gregoryg03/swim_clock_general/README.md

# swim_clock_general
General Project code development and other related files

Basic testing is being conducted on Arduino Uno with 4 7-segment LEDs

Plan to move to ESP 32
