gregoryg03/swim_clock_general/hardware/bps_board_v2/bps_board_v2.kicad_pcb

## KiCad design hardware/bps_board_v2/bps_board_v2.kicad_pcb (2026-05-01)

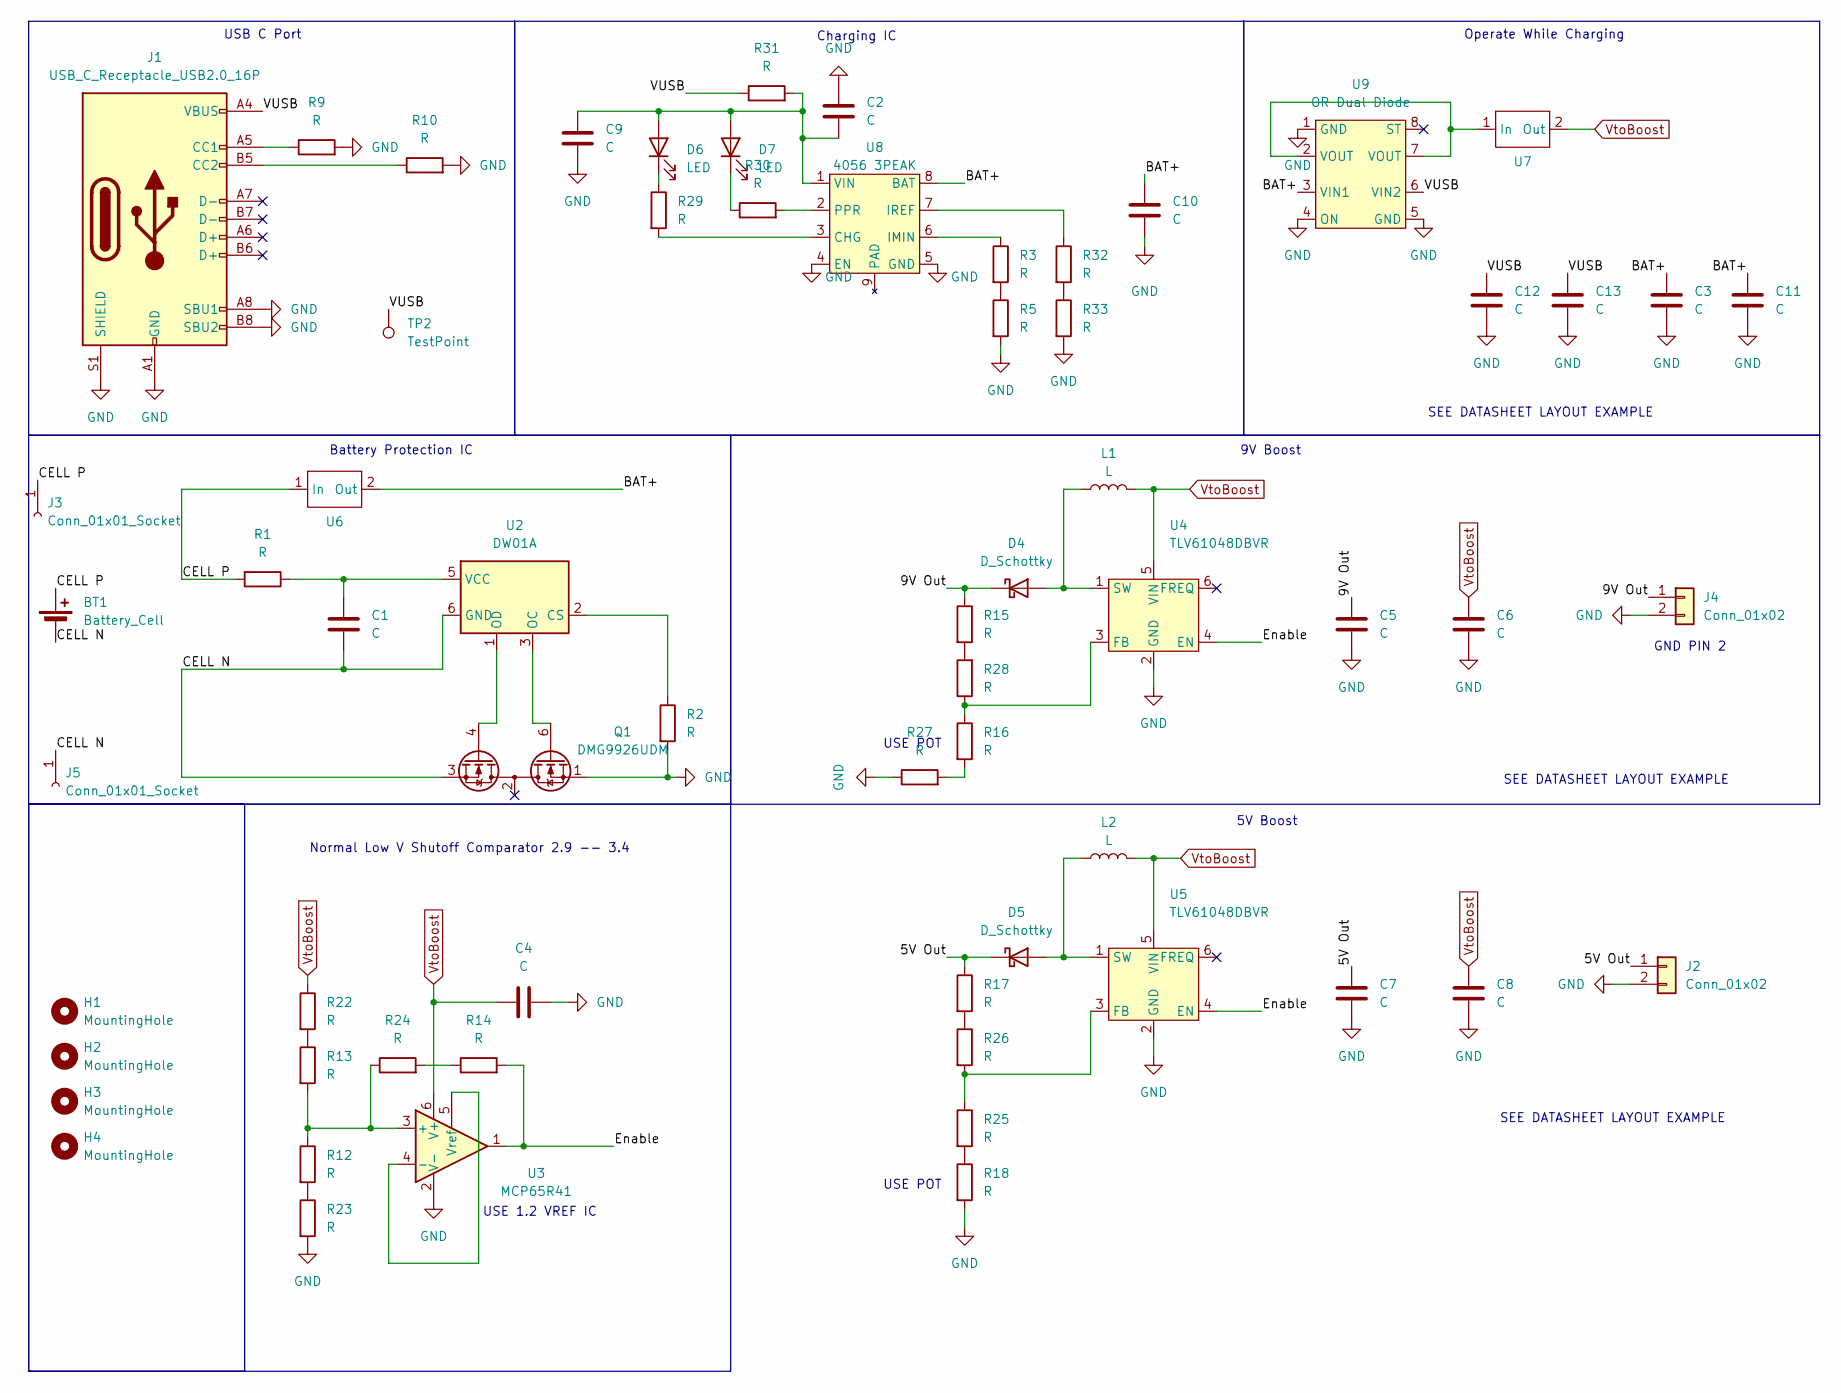
[picture p1: schematic bps_board_v2.kicad_sch, BPS Circuit Board]

Parts:
BT1: Battery_Cell; 18650 8mm Strip
C1, C2, C3, C4, C5, C6, C7, C8, C9, C10, C11, C12, C13: C; C_1206_3216Metric_Pad1.33x1.80mm_HandSolder
D4, D5: D_Schottky; MBRS130LT3G Diode
D6, D7: LED; LED_0603_1608Metric_Pad1.05x0.95mm_HandSolder
H1, H2, H3, H4: MountingHole; MountingHole_3.2mm_M3
J1: USB_C_Receptacle_USB2.0_16P; USB_C_Receptacle_GCT_USB4085
J2, J4: Conn_01x02; JST_EH_B2B-EH-A_1x02_P2.50mm_Vertical
J3, J5: Conn_01x01_Socket; EmptyPad
L1, L2: L; InductorFixed
Q1: DMG9926UDM; SOT-23-6
R1, R2, R3, R5, R9, R10, R12, R13, R14, R15, R16, R17, R18, R22, R23, R24, R25, R26, R27, R28, R29, R30, R31, R32, R33: R; R_1206_3216Metric_Pad1.30x1.75mm_HandSolder
TP2: TestPoint; TestPoint_THTPad_2.5x2.5mm_Drill1.2mm
U2: DW01A; SOT-23-6
U3: MCP65R41; SOT-23-6
U4, U5: TLV61048DBVR; SOT-23-6_Handsoldering
U6, U7: 22AWG Wire Jump
U8: 4056 3PEAK; SOIC-8-1EP_3.9x4.9mm_P1.27mm_EP2.41x3.3mm_ThermalVias
U9: OR Dual Diode; SOT-583-8

Connections:
/5V Out: C7.1, D5.1 (K), J2.1, R17.1
/9V Out: C5.1, D4.1 (K), J4.1, R15.1
/BAT+: C3.1, C10.1, C11.1, U6.2 (Out), U8.8 (BAT), U9.3 (VIN1)
/CELL N: BT1.2 (-), C1.2, J5.1, Q1.3 (S2), U2.6 (GND)
/CELL P: BT1.1 (+), J3.1, R1.2, U6.1 (In)
/Enable: R14.2, U3.1, U4.4 (EN), U5.4 (EN)
/VUSB: C12.1, C13.1, J1.A4 (VBUS), J1.A9 (VBUS), J1.B4 (VBUS), J1.B9 (VBUS), R31.1, TP2.1, U9.6 (VIN2)
GND: C2.1, C3.2, C4.2, C5.2, C6.2, C7.2, C8.2, C9.2, C10.2, C11.2, C12.2, C13.2, J1.A1 (GND), J1.A8 (SBU1), J1.A12 (GND), J1.B1 (GND), J1.B8 (SBU2), J1.B12 (GND), J1.S1 (SHIELD), J2.2, J4.2, Q1.1 (D1), R2.2, R5.2, R9.2, R10.2, R18.2, R23.2, R27.1, R33.2, U3.2 (V-), U4.2 (GND), U5.2 (GND), U8.4 (EN), U8.5 (GND), U9.1 (GND), U9.4 (ON), U9.5 (GND)
unnamed: D4.2 (A), L1.1, U4.1 (SW)
unnamed: D5.2 (A), L2.1, U5.1 (SW)
unnamed: C2.2, C9.1, D6.2 (A), D7.2 (A), R31.2, U8.1 (VIN)
unnamed: D6.1 (K), R29.1
unnamed: D7.1 (K), R30.1
unnamed: J1.A5 (CC1), R9.1
unnamed: J1.B5 (CC2), R10.1
unnamed: Q1.6 (G1), U2.3 (OC)
unnamed: Q1.4 (G2), U2.1 (OD)
unnamed: R3.2, R5.1
unnamed: R12.2, R23.1
unnamed: R13.1, R22.2
unnamed: R14.1, R24.2
unnamed: R15.2, R28.2
unnamed: R16.2, R27.2
unnamed: R17.2, R26.1
unnamed: R18.1, R25.2
unnamed: R32.2, R33.1
unnamed: R2.1, U2.2 (CS)
unnamed: C1.1, R1.1, U2.5 (VCC)
unnamed: R12.1, R13.2, R24.1, U3.3 (+)
unnamed: U3.4 (-), U3.5 (Vref)
unnamed: R16.1, R28.1, U4.3 (FB)
unnamed: R25.1, R26.2, U5.3 (FB)
unnamed: U7.1 (In), U9.2 (VOUT), U9.7 (VOUT)
unnamed: R29.2, U8.3 (CHG)
unnamed: R3.1, U8.6 (IMIN)
unnamed: R32.1, U8.7 (IREF)
unnamed: R30.2, U8.2 (PPR)
VtoBoost: C4.1, C6.1, C8.1, L1.2, L2.2, R22.1, U3.6 (V+), U4.5 (VIN), U5.5 (VIN), U7.2 (Out)

Notes on the sheet:
USE 1.2 VREF IC
SEE DATASHEET LAYOUT EXAMPLE
Battery Protection IC
Charging IC
GND PIN 2
USE POT
5V Boost
Operate While Charging
USB C Port
Normal Low V Shutoff Comparator 2.9 -- 3.4
9V Boost

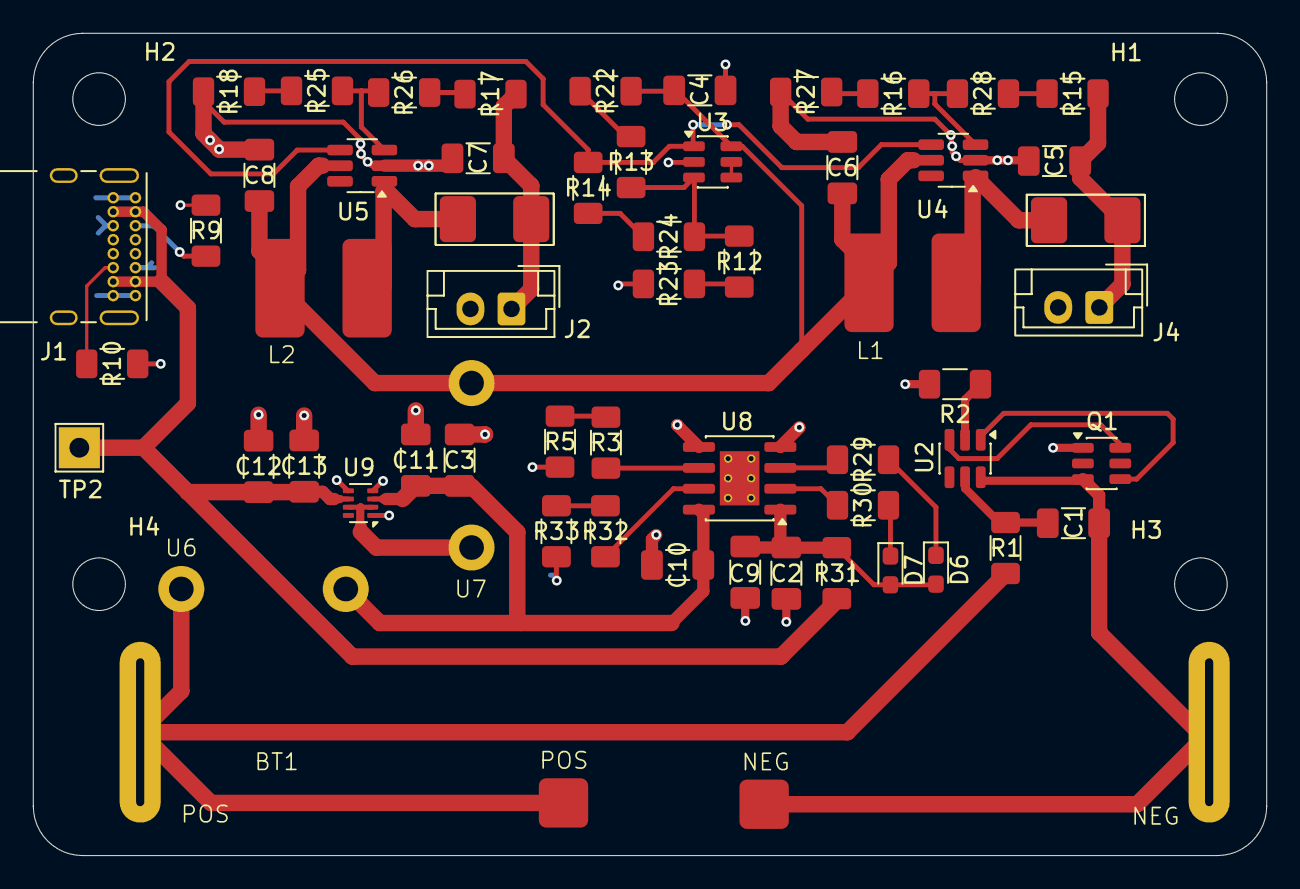
[picture p2: board bps_board_v2.kicad_pcb from above]

Board: 2 copper layers, 75.0 x 50.0 mm, 64 parts (0 on the bottom side), 38 nets.
