gregoryg03/swim_clock_general/hardware/main_board_v2/MainBoard4Layer/MainBoard4Layer.kicad_pcb

## KiCad design hardware/main_board_v2/MainBoard4Layer/MainBoard4Layer.kicad_pcb (2026-04-23)

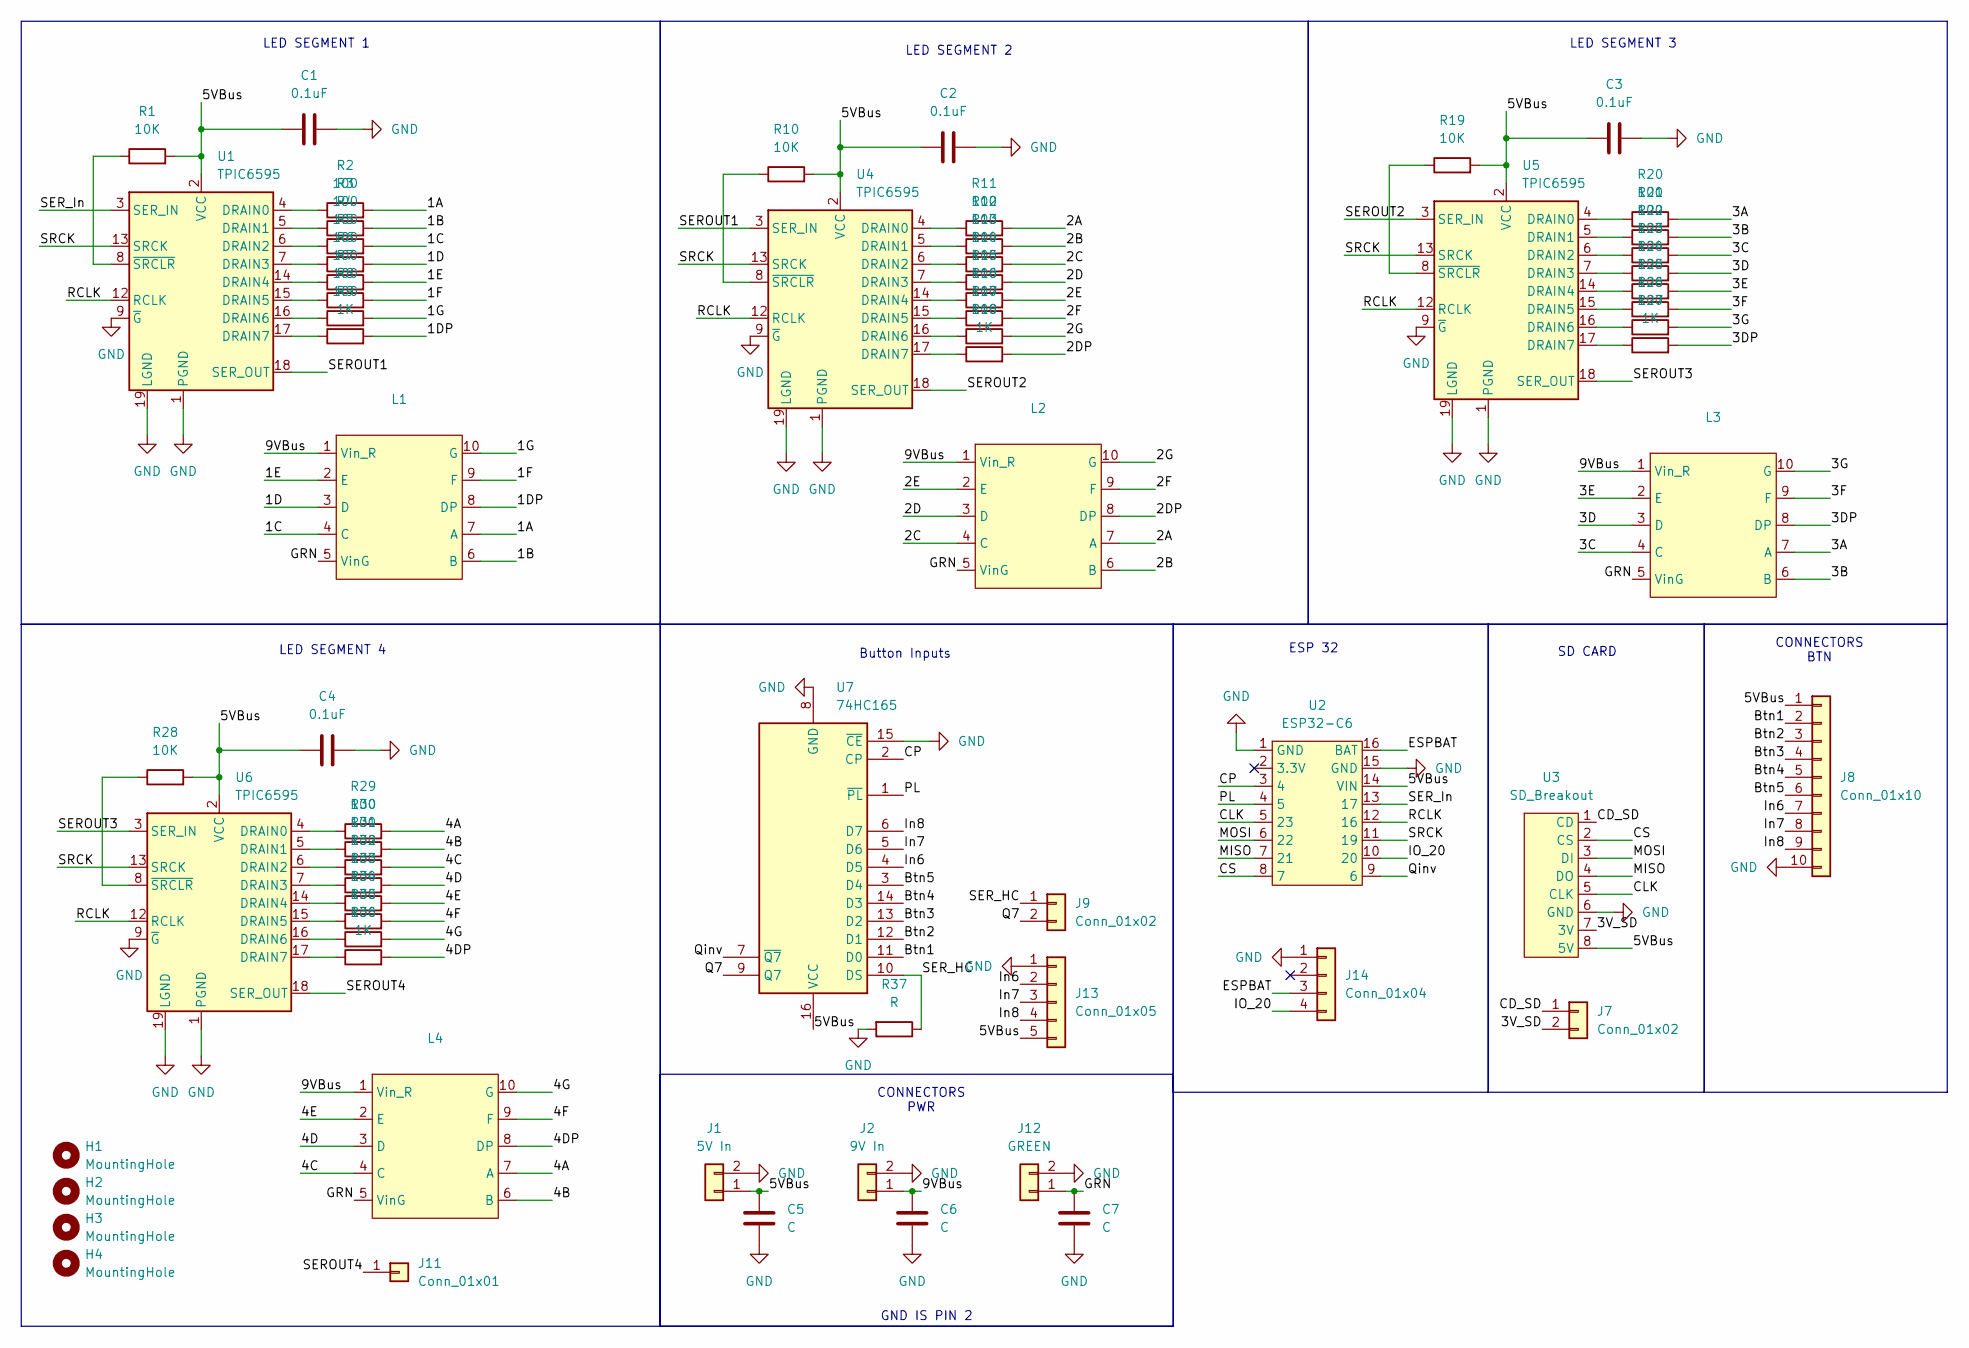
[picture p3: schematic MainBoard4Layer.kicad_sch]

Parts:
C1, C2, C3, C4: 0.1uF; C_1206_3216Metric_Pad1.33x1.80mm_HandSolder
C5, C6, C7: C; C_1206_3216Metric_Pad1.33x1.80mm_HandSolder
H1, H2, H3, H4: MountingHole; MountingHole_3.2mm_M3
J1: 5V In; JST_EH_B2B-EH-A_1x02_P2.50mm_Vertical
J2: 9V In; JST_EH_B2B-EH-A_1x02_P2.50mm_Vertical
J7, J9: Conn_01x02; PinHeader_1x02_P2.54mm_Vertical
J8: Conn_01x10; MOLEX_10_PIN
J11: Conn_01x01; PinSocket_1x01_P2.54mm_Vertical
J12: GREEN; JST_EH_B2B-EH-A_1x02_P2.50mm_Vertical
J13: Conn_01x05; PinHeader_1x05_P2.54mm_Vertical
J14: Conn_01x04; PinHeader_1x04_P2.54mm_Vertical
L1, L2, L3, L4: 7SEG_LED_2.3IN
R1, R10, R19, R28: 10K; R_1206_3216Metric_Pad1.30x1.75mm_HandSolder
R2, R3, R4, R5, R6, R7, R8, R11, R12, R13, R14, R15, R16, R17, R20, R21, R22, R23, R24, R25, R26, R29, R30, R31, R32, R33, R34, R35: 100; R_1206_3216Metric_Pad1.30x1.75mm_HandSolder
R9, R18, R27, R36: 1K; R_1206_3216Metric_Pad1.30x1.75mm_HandSolder
R37: R; R_1206_3216Metric_Pad1.30x1.75mm_HandSolder
U1, U4, U5, U6: TPIC6595; DIP-20_W7.62mm_Socket
U2: ESP32-C6; ESPC6_BEETLE
U3: SD_Breakout; SD Card
U7: 74HC165; DIP-16_W7.62mm_Socket

Connections:
/1A: L1.7 (A), R2.2
/1B: L1.6 (B), R3.2
/1C: L1.4 (C), R4.2
/1D: L1.3 (D), R5.2
/1DP: L1.8 (DP), R9.2
/1E: L1.2 (E), R6.2
/1F: L1.9 (F), R7.2
/1G: L1.10 (G), R8.2
/2A: L2.7 (A), R11.2
/2B: L2.6 (B), R12.2
/2C: L2.4 (C), R13.2
/2D: L2.3 (D), R14.2
/2DP: L2.8 (DP), R18.2
/2E: L2.2 (E), R15.2
/2F: L2.9 (F), R16.2
/2G: L2.10 (G), R17.2
/3A: L3.7 (A), R20.2
/3B: L3.6 (B), R21.2
/3C: L3.4 (C), R22.2
/3D: L3.3 (D), R23.2
/3DP: L3.8 (DP), R27.2
/3E: L3.2 (E), R24.2
/3F: L3.9 (F), R25.2
/3G: L3.10 (G), R26.2
/3V_SD: J7.2, U3.7 (3V)
/4A: L4.7 (A), R29.2
/4B: L4.6 (B), R30.2
/4C: L4.4 (C), R31.2
/4D: L4.3 (D), R32.2
/4DP: L4.8 (DP), R36.2
/4E: L4.2 (E), R33.2
/4F: L4.9 (F), R34.2
/4G: L4.10 (G), R35.2
/5VBus: C1.1, C2.1, C3.1, C4.1, C5.1, J1.1, J8.1, J13.5, R1.2, R10.2, R19.2, R28.2, U1.2 (VCC), U2.14 (VIN), U3.8 (5V), U4.2 (VCC), U5.2 (VCC), U6.2 (VCC), U7.16 (VCC)
/9VBus: C6.1, J2.1, L1.1 (Vin_R), L2.1 (Vin_R), L3.1 (Vin_R), L4.1 (Vin_R)
/Btn1: J8.2, U7.11 (D0)
/Btn2: J8.3, U7.12 (D1)
/Btn3: J8.4, U7.13 (D2)
/Btn4: J8.5, U7.14 (D3)
/Btn5: J8.6, U7.3 (D4)
/CD_SD: J7.1, U3.1 (CD)
/CLK: U2.5 (23), U3.5 (CLK)
/CP: U2.3 (4), U7.2 (CP)
/CS: U2.8 (7), U3.2 (CS)
/ESPBAT: J14.3, U2.16 (BAT)
/GRN: C7.1, J12.1, L1.5 (VinG), L2.5 (VinG), L3.5 (VinG), L4.5 (VinG)
/IO_20: J14.4, U2.10 (20)
/In6: J8.7, J13.2, U7.4 (D5)
/In7: J8.8, J13.3, U7.5 (D6)
/In8: J8.9, J13.4, U7.6 (D7)
/MISO: U2.7 (21), U3.4 (DO)
/MOSI: U2.6 (22), U3.3 (DI)
/PL: U2.4 (5), U7.1 (~PL)
/Q7: J9.2, U7.9 (Q7)
/Qinv: U2.9 (6), U7.7 (~Q7)
/RCLK: U1.12 (RCLK), U2.12 (16), U4.12 (RCLK), U5.12 (RCLK), U6.12 (RCLK)
/SEROUT1: U1.18 (SER_OUT), U4.3 (SER_IN)
/SEROUT2: U4.18 (SER_OUT), U5.3 (SER_IN)
/SEROUT3: U5.18 (SER_OUT), U6.3 (SER_IN)
/SEROUT4: J11.1, U6.18 (SER_OUT)
/SER_HC: J9.1, R37.1, U7.10 (DS)
/SER_In: U1.3 (SER_IN), U2.13 (17)
/SRCK: U1.13 (SRCK), U2.11 (19), U4.13 (SRCK), U5.13 (SRCK), U6.13 (SRCK)
GND: C1.2, C2.2, C3.2, C4.2, C5.2, C6.2, C7.2, J1.2, J2.2, J8.10, J12.2, J13.1, J14.1, R37.2, U1.1 (PGND), U1.9 (~G), U1.10 (PGND), U1.11 (PGND), U1.19 (LGND), U1.20 (PGND), U2.1 (GND), U2.15 (GND), U3.6 (GND), U4.1 (PGND), U4.9 (~G), U4.10 (PGND), U4.11 (PGND), U4.19 (LGND), U4.20 (PGND), U5.1 (PGND), U5.9 (~G), U5.10 (PGND), U5.11 (PGND), U5.19 (LGND), U5.20 (PGND), U6.1 (PGND), U6.9 (~G), U6.10 (PGND), U6.11 (PGND), U6.19 (LGND), U6.20 (PGND), U7.8 (GND), U7.15 (~CE)
unnamed: R2.1, U1.4 (DRAIN0)
unnamed: R3.1, U1.5 (DRAIN1)
unnamed: R4.1, U1.6 (DRAIN2)
unnamed: R5.1, U1.7 (DRAIN3)
unnamed: R6.1, U1.14 (DRAIN4)
unnamed: R7.1, U1.15 (DRAIN5)
unnamed: R8.1, U1.16 (DRAIN6)
unnamed: R9.1, U1.17 (DRAIN7)
unnamed: R1.1, U1.8 (~SRCLR)
unnamed: R11.1, U4.4 (DRAIN0)
unnamed: R12.1, U4.5 (DRAIN1)
unnamed: R13.1, U4.6 (DRAIN2)
unnamed: R14.1, U4.7 (DRAIN3)
unnamed: R15.1, U4.14 (DRAIN4)
unnamed: R16.1, U4.15 (DRAIN5)
unnamed: R17.1, U4.16 (DRAIN6)
unnamed: R18.1, U4.17 (DRAIN7)
unnamed: R10.1, U4.8 (~SRCLR)
unnamed: R20.1, U5.4 (DRAIN0)
unnamed: R21.1, U5.5 (DRAIN1)
unnamed: R22.1, U5.6 (DRAIN2)
unnamed: R23.1, U5.7 (DRAIN3)
unnamed: R24.1, U5.14 (DRAIN4)
unnamed: R25.1, U5.15 (DRAIN5)
unnamed: R26.1, U5.16 (DRAIN6)
unnamed: R27.1, U5.17 (DRAIN7)
unnamed: R19.1, U5.8 (~SRCLR)
unnamed: R29.1, U6.4 (DRAIN0)
unnamed: R30.1, U6.5 (DRAIN1)
unnamed: R31.1, U6.6 (DRAIN2)
unnamed: R32.1, U6.7 (DRAIN3)
unnamed: R33.1, U6.14 (DRAIN4)
unnamed: R34.1, U6.15 (DRAIN5)
unnamed: R35.1, U6.16 (DRAIN6)
unnamed: R36.1, U6.17 (DRAIN7)
unnamed: R28.1, U6.8 (~SRCLR)

Notes on the sheet:
LED SEGMENT 2
Button Inputs
LED SEGMENT 4
SD CARD
CONNECTORS BTN
ESP 32
LED SEGMENT 3
GND IS PIN 2
LED SEGMENT 1
CONNECTORS PWR

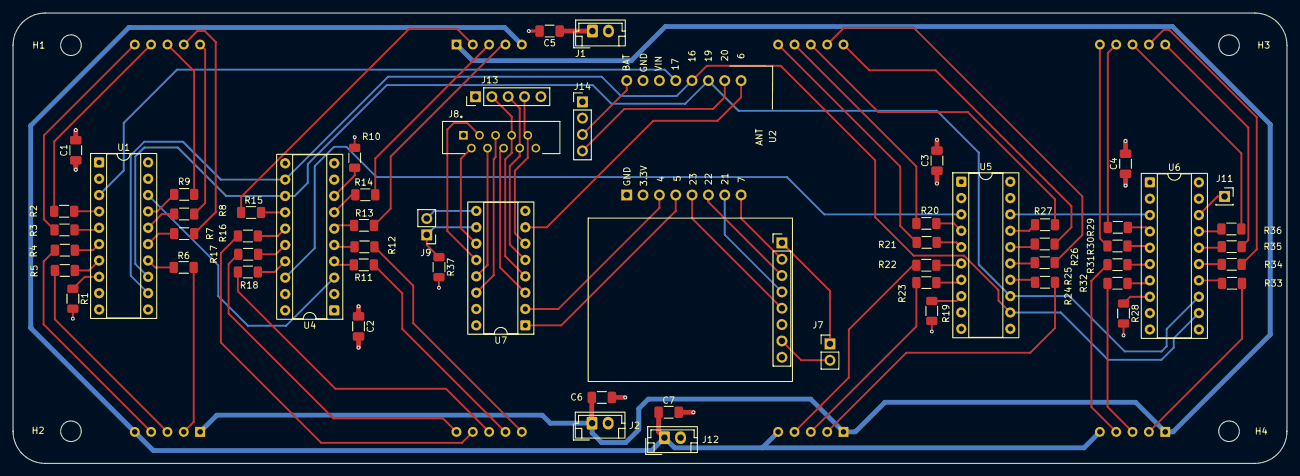
[picture p4: board MainBoard4Layer.kicad_pcb from above]

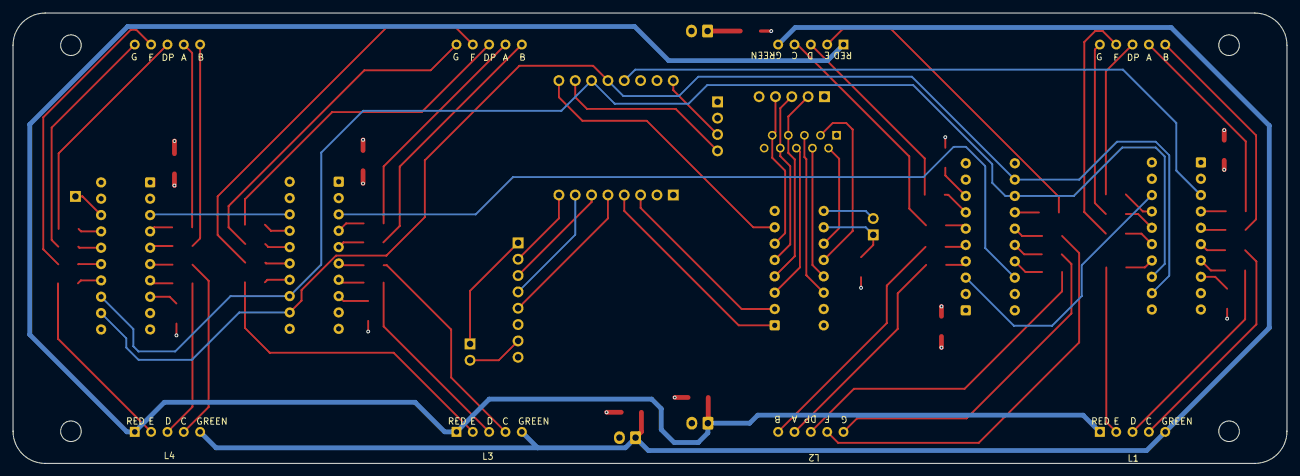
[picture p5: board MainBoard4Layer.kicad_pcb from below]

Board: 4 copper layers, 198.0 x 70.0 mm, 68 parts (4 on the bottom side), 100 nets.
