gregoryg03/swim_clock_general/hardware/btn_board/BTN_Board.kicad_pcb

## KiCad design hardware/btn_board/BTN_Board.kicad_pcb (2026-03-08)

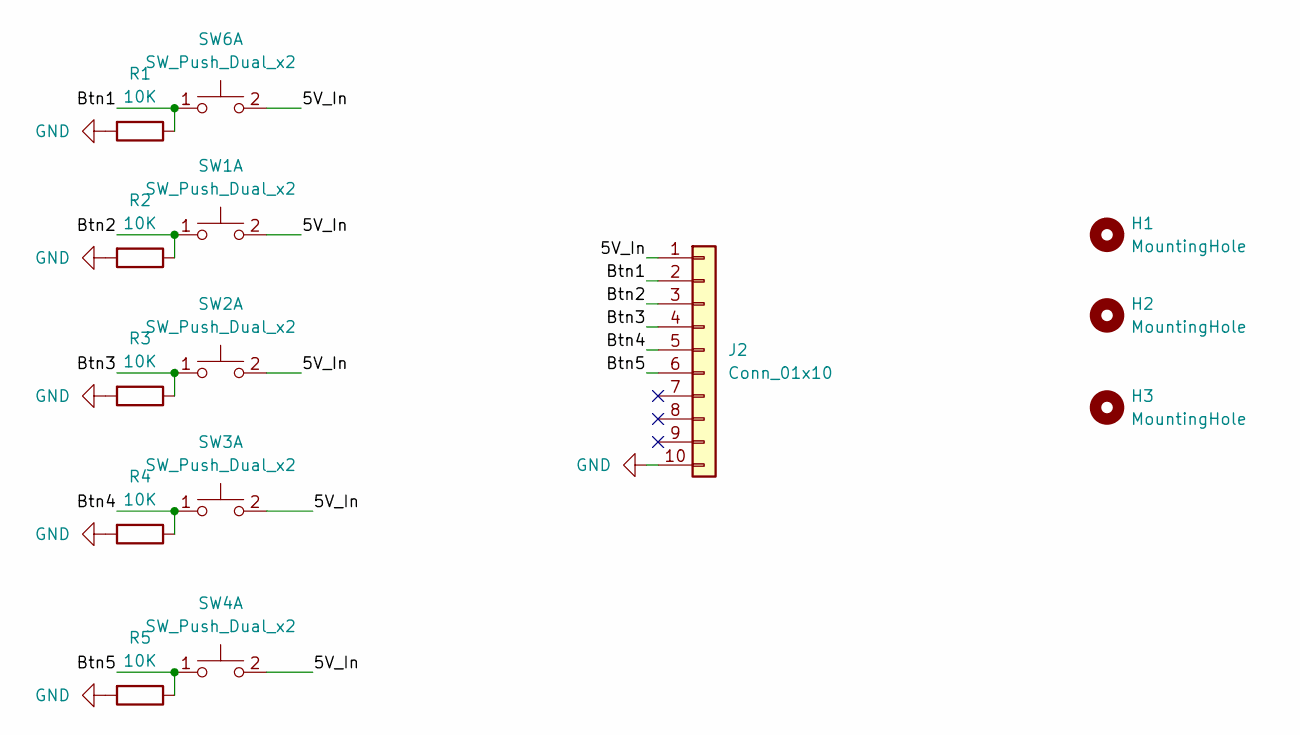
[picture p6: schematic BTN_Board.kicad_sch]

Parts:
H1, H2, H3: MountingHole; MountingHole_3.2mm_M3
J2: Conn_01x10; MOLEX_10_PIN
R1, R2, R3, R4, R5: 10K; R_1206_3216Metric_Pad1.30x1.75mm_HandSolder
SW1, SW2, SW3, SW4, SW6: SW_Push_Dual_x2; 12mm BTN Backside

Connections:
/5V_In: J2.1, SW1.2 (D), SW2.2 (D), SW3.2 (D), SW4.2 (D), SW6.2 (D); also elsewhere on the board
/Btn1: J2.2, R1.1, SW6.1 (C); also elsewhere on the board
/Btn2: J2.3, R2.1, SW1.1 (C)
/Btn3: J2.4, R3.1, SW2.1 (C)
/Btn4: J2.5, R4.1, SW3.1 (C)
/Btn5: J2.6, R5.1, SW4.1 (C)
GND: J2.10, R1.2, R2.2, R3.2, R4.2, R5.2

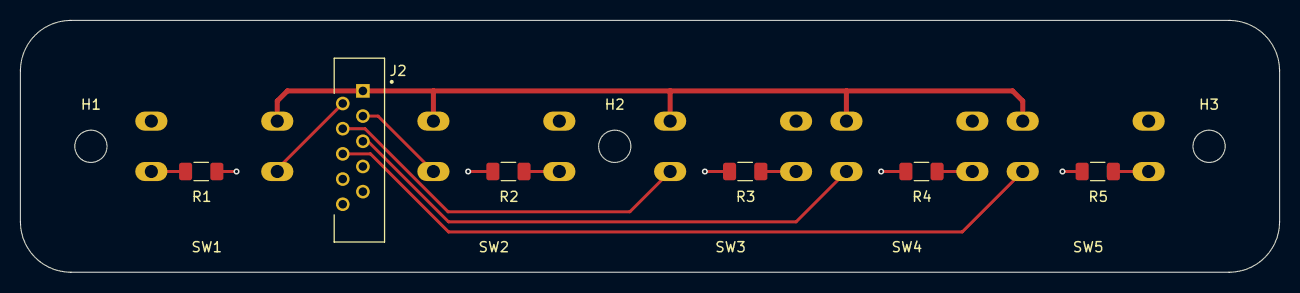
[picture p7: board BTN_Board.kicad_pcb from above]

Board: 2 copper layers, 125.0 x 25.0 mm, 14 parts (0 on the bottom side), 7 nets.

Other parts of the board:
SW5: SW_Push_Dual_x2; 12mm BTN Backside

Their connections:
/5V_In: SW5.2 (D); also elsewhere on the board
/Btn1: SW5.1 (C); also elsewhere on the board
