gregoryg03/swim_clock_general/hardware/tpic_breakout/TPIC_Breakout.kicad_pcb

## KiCad design hardware/tpic_breakout/TPIC_Breakout.kicad_pcb (2026-02-19)

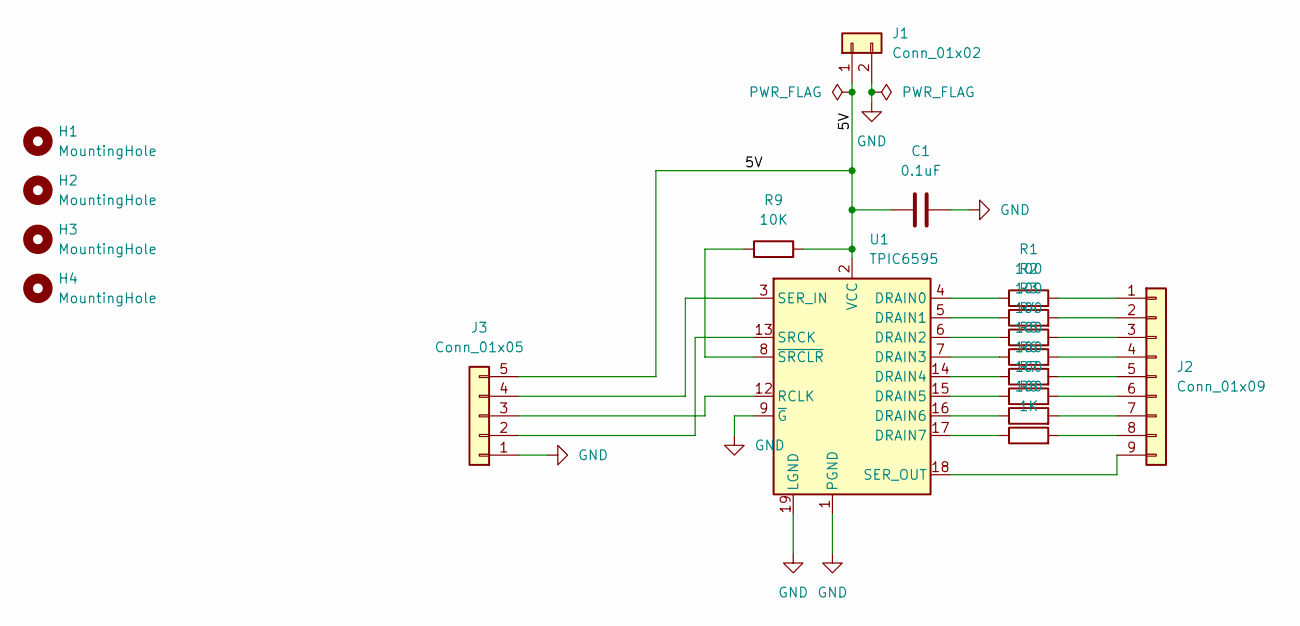
[picture p8: schematic TPIC_Breakout.kicad_sch, TPIC Board]

Parts:
C1: 0.1uF; C_Disc_D5.0mm_W2.5mm_P2.50mm
H1, H2, H3, H4: MountingHole; MountingHole_2.2mm_M2
J1: Conn_01x02; JST_EH_B2B-EH-A_1x02_P2.50mm_Vertical
J2: Conn_01x09; PinSocket_1x09_P2.54mm_Vertical
J3: Conn_01x05; PinSocket_1x05_P2.54mm_Vertical
R1, R2, R3, R4, R5, R6, R7: 100; R_1206_3216Metric_Pad1.30x1.75mm_HandSolder
R8: 1K; R_1206_3216Metric_Pad1.30x1.75mm_HandSolder
R9: 10K; R_1206_3216Metric_Pad1.30x1.75mm_HandSolder
U1: TPIC6595; DIP-20_W7.62mm

Connections:
/5V: C1.1, J1.1, J3.5, R9.2, U1.2 (VCC)
GND: C1.2, J1.2, J3.1, U1.1 (PGND), U1.9 (~G), U1.10 (PGND), U1.11 (PGND), U1.19 (LGND), U1.20 (PGND)
unnamed: J2.1, R1.2
unnamed: J2.2, R2.2
unnamed: J2.3, R3.2
unnamed: J2.4, R4.2
unnamed: J2.5, R5.2
unnamed: J2.6, R6.2
unnamed: J2.7, R7.2
unnamed: J2.8, R8.2
unnamed: J2.9, U1.18 (SER_OUT)
unnamed: J3.2, U1.13 (SRCK)
unnamed: J3.3, U1.12 (RCLK)
unnamed: J3.4, U1.3 (SER_IN)
unnamed: R1.1, U1.4 (DRAIN0)
unnamed: R2.1, U1.5 (DRAIN1)
unnamed: R3.1, U1.6 (DRAIN2)
unnamed: R4.1, U1.7 (DRAIN3)
unnamed: R5.1, U1.14 (DRAIN4)
unnamed: R6.1, U1.15 (DRAIN5)
unnamed: R7.1, U1.16 (DRAIN6)
unnamed: R8.1, U1.17 (DRAIN7)
unnamed: R9.1, U1.8 (~SRCLR)

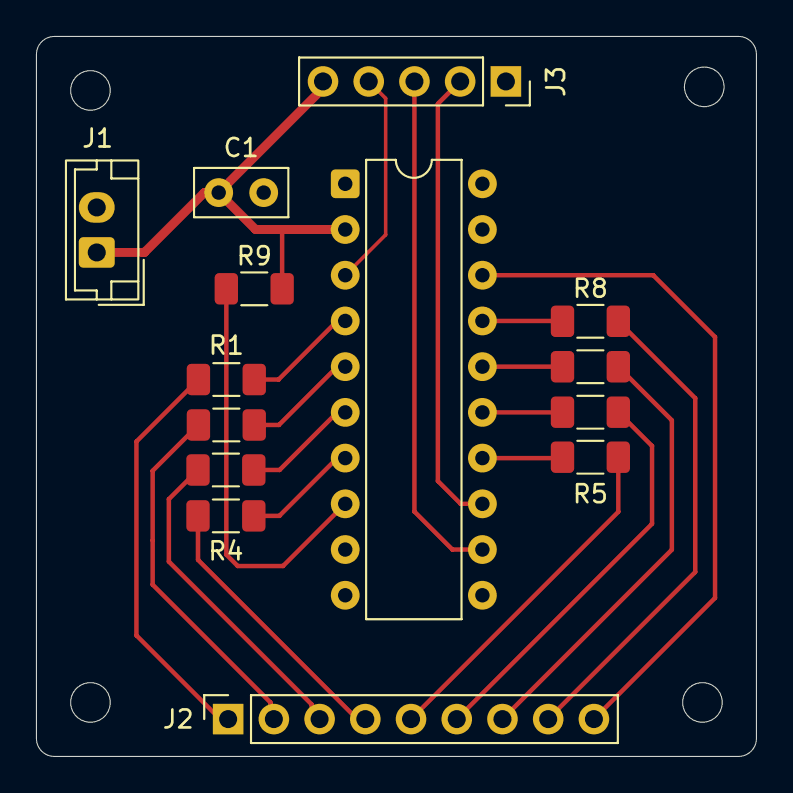
[picture p9: board TPIC_Breakout.kicad_pcb from above]

Board: 2 copper layers, 40.0 x 40.0 mm, 18 parts (0 on the bottom side), 23 nets.
