gregoryg03/swim_clock_general/firmware/swim_clock_esp_v1/main/main.cpp

#include <stdio.h>
#include <stdint.h>
#include "sd_card.h"
#include "button_poll.h"
#include "events.h"
#include "display.h"
#include <sys/stat.h>
#include "esp_log.h"
#include "freertos/FreeRTOS.h"
#include "freertos/task.h"

static const char *TAG = "main_debug";

const gpio_num_t LATCH_PIN = GPIO_NUM_16;
const gpio_num_t DISP_CLOCK_PIN = GPIO_NUM_19;
const gpio_num_t DISP_DATA_PIN = GPIO_NUM_17;
const gpio_num_t DATA_PIN = GPIO_NUM_6;
const gpio_num_t CLOCK_PIN = GPIO_NUM_4;
const gpio_num_t MODE_PIN = GPIO_NUM_5;
const gpio_num_t CS_PIN = GPIO_NUM_7;
const gpio_num_t MOSI = GPIO_NUM_22;
const gpio_num_t MISO = GPIO_NUM_21;
const gpio_num_t SD_CLK = GPIO_NUM_23;

ShiftReg shiftReg;

Event event;

void btn_task(void *pvParameters)
{
    while (1) {
        //ESP_LOGI(TAG, "Btn Task Running");

        event = shiftReg.poll();

        vTaskDelay(pdMS_TO_TICKS(40));
    }
}

void disp_task(void *pvParameters)
{
    while (1) {
        //ESP_LOGI(TAG, "Disp Task Running");
        handle_events(event);
        vTaskDelay(pdMS_TO_TICKS(40));
    }
}

extern "C" {

    void app_main(void)
    {
        ESP_LOGI(TAG, "Main running");

        shiftReg.buttons_init(DATA_PIN, CLOCK_PIN, MODE_PIN);

        init_events();

        display_init(LATCH_PIN, DISP_CLOCK_PIN, DISP_DATA_PIN);

        sd_init(MOSI, MISO, SD_CLK, CS_PIN);

        xTaskCreate(
            btn_task,
            "btn_task",
            2048,
            NULL,
            5,
            NULL
        );

        xTaskCreate(
            disp_task,
            "disp_task",
            2048,
            NULL,
            5,
            NULL
        );

    // while (1) {
    //     event = shiftReg.poll();

    //     vTaskDelay(pdMS_TO_TICKS(20));


    //     //ESP_LOGI(TAG, "%d", static_cast<int>(event));

    // }
    }
}
