gregoryg03/swim_clock_general/firmware/swim_clock_esp_v1/components/Buttons/button_poll.h

#ifndef BUTTON_POLL
#define BUTTON_POLL

#include <stdio.h>
#include <stdint.h>
#include "events.h"
#include "driver/gpio.h"
#include "freertos/FreeRTOS.h"
#include <sys/stat.h>
#include "esp_log.h"
#include "esp_timer.h"


#define BTN_COUNT 8
#define DEBOUNCE 30000 //time in ms

#define BYTE_TO_BINARY_PATTERN "%c%c%c%c%c%c%c%c"
#define BYTE_TO_BINARY(byte)  \
  ((byte) & 0x80 ? '1' : '0'), \
  ((byte) & 0x40 ? '1' : '0'), \
  ((byte) & 0x20 ? '1' : '0'), \
  ((byte) & 0x10 ? '1' : '0'), \
  ((byte) & 0x08 ? '1' : '0'), \
  ((byte) & 0x04 ? '1' : '0'), \
  ((byte) & 0x02 ? '1' : '0'), \
  ((byte) & 0x01 ? '1' : '0')

class ShiftReg {
    public: 
    Event poll();
    void buttons_init(gpio_num_t, gpio_num_t, gpio_num_t);

    private:
    uint8_t read_button(bool);
    uint8_t update_state(uint8_t);
    uint8_t edge_detect(uint8_t);
};

#endif 
