gregoryg03/swim_clock_general/firmware/vscode_project/include/events.h

#ifndef EVENTS_H
#define EVENTS_H

#include <Arduino.h>
#include "functions.h"
#include "sd2.h"

#define BLINK_RATE 500 //time in ms

enum class event {
    none,
    btn1press,
    btn2press,
    btn3press,
    btn4press,
    btn5press
    };

enum class mode {
    countUp,
    countDown,
    dataEntry,
    shutdown,
    MAX_MODES
};

struct modeState {
    void(*enter)();
    void(*run)();
    void(*exit)();
};


void enter_countUp();
void run_countUp();
void exit_countUp();

void enter_countDown();
void run_countDown();
void exit_countDown();

void enter_dataEntry();
void run_dataEntry();
void exit_dataEntry();

void enter_shutdown();
void run_shutdown();
void exit_shutdown();

extern modeState modeTable[];

enum class actions {
    running,
    paused,
    cycle,
    enter
};

void init_events(void);


mode handle_events(event);

void set_action (event);

extern actions action;

extern mode m;

void remTime(void);

void next_mode(mode);

void disp(mode);

void reset_disp();

void change_state(mode);

uint16_t sd_data_in_format(uint8_t[]);

#endif
