gregoryg03/swim_clock_general/firmware/vscode_project/src/button.cpp

#include "button.h"

//74HC165 Shift Register
//Data Out Inverse
static int DATA_PIN;
//Clock
static int CLOCK_PIN;
//Shift/Load High = Shift data & Low = Load Data
static int MODE_PIN;

//Debounce
static byte last_read = 0xFF;
static byte last_state = 0xFF;
static unsigned long lastDebounce[BTN_COUNT] = {0};


//Initilize buttons
void buttons_init(uint8_t data, uint8_t clock, uint8_t mode)
{
    DATA_PIN = data;
    CLOCK_PIN = clock;
    MODE_PIN = mode;

    pinMode(DATA_PIN, INPUT);
    pinMode(CLOCK_PIN, OUTPUT);
    pinMode(MODE_PIN, OUTPUT);

    digitalWrite(CLOCK_PIN, LOW);
    digitalWrite(MODE_PIN, LOW);
}

void fill_reg(void)
{
  digitalWrite(MODE_PIN, LOW);
  delayMicroseconds(5);
  digitalWrite(MODE_PIN, HIGH);
  delayMicroseconds(5);
}

event buttons::poll()
{
  byte reading = read_button(false);
  byte pressed = edge_detect(reading);

  //Serial.println("polling");

  if ((pressed >> 0) & 1)
    return event::btn1press;

  if ((pressed >> 1) & 1)
    return event::btn2press;
  
  if ((pressed >> 2) & 1)
    return event::btn3press;
  
  if ((pressed >> 3) & 1)
    return event::btn4press;

  if ((pressed >> 4) & 1)
    return event::btn5press;
  
  return event::none;
}

//Detect when the button is pressed to change state (if not it will bounce)
byte edge_detect(byte reading)
{
  static byte btnEdgeDetect = 0;
  byte output = reading & ~btnEdgeDetect;
  btnEdgeDetect = reading;

  return output;
}


//Can choose order based on bool, default is false
byte read_button(bool order)
{
  fill_reg();
  byte value = 0;
  switch (order) {
    //MSBF
    case true: 
      for (int i = 0; i < BTN_COUNT; i++) {
        value |= (digitalRead(DATA_PIN) << i);
        digitalWrite(CLOCK_PIN, HIGH);
        digitalWrite(CLOCK_PIN, LOW);
      }
      break;
    //LSBF
    default:
      for (int i = 0; i < BTN_COUNT; i++) {
        value |= (digitalRead(DATA_PIN) << (7-i));
        digitalWrite(CLOCK_PIN, HIGH);
        digitalWrite(CLOCK_PIN, LOW);
      }
      break;
  }

  //Serial.println(value);
  
  return ~update_state(value);
}

byte update_state(byte value)
{
  byte mask = 1;
  unsigned long curtime = millis();
  
  for (int i = 0; i < BTN_COUNT; i++) {
    if (((value >> i) & mask) != ((last_read >> i) & mask)) {
      lastDebounce[i] = curtime;
      last_read = (last_read & ~(1 << i)) | (((value >> i) & 1) << i);
    }
  }

  for (int i = 0; i < BTN_COUNT; i++) {
    if ((curtime - lastDebounce[i]) > DEBOUNCE) {
      bool currentBit = (value >> i) & 1;
      last_state = (last_state & ~(1 << i)) | (currentBit << i);
    }
  }

return last_state;
}
