gregoryg03/swim_clock_general/(commit log)

2026-02-19 Updated main.ino to the correct file
    [main.ino]
2026-02-19 Created hardware sub-folders to add kicad files from PC
2026-02-19 Added files from KICAD
    [MainBoard.kicad_pcb, MainBoard.kicad_sch]
2026-02-20 Updated main_boad sch | Created btn_board files
    [BTN_Board.kicad_pcb, BTN_Board.kicad_sch, MainBoard.kicad_sch]
2026-02-20 Changed dp check to bitwise | adding setting LED blank before 0s | Shortent 0s in setup | Formatting
    [main.ino]
2026-02-27 Migrated from Arduino IDE to Platform.io project is VSCode
2026-03-01 created button testing project and updated main in vscode project to count down
2026-03-01 Updated button logic and added options for loading order from shiftreg | moved timer reset location in cscode_prj
    [main.cpp]
2026-03-01 Fixed case break and removed extra input
    [main.cpp]
2026-03-02 added debounce to the button_testing | Integrated this work into vscode_project and rearchitectured the files
2026-03-05 Updated main board to finish footprint assignment
    [MainBoard.kicad_sch]
2026-03-05 Added custom footprints in pretty folder
2026-03-08 Draft of btn board
    [BTN_Board.kicad_pcb, BTN_Board.kicad_sch]
2026-03-08 Finished btn board and generated gerbers
    [BTN_Board-B_Cu.gbr, BTN_Board-B_Mask.gbr, BTN_Board-B_Paste.gbr, BTN_Board-B_Silkscreen.gbr, BTN_Board-Edge_Cuts.gbr, BTN_Board-F_Cu.gbr, BTN_Board-F_Mask.gbr, BTN_Board-F_Paste.gbr]
2026-03-09 Started PCB layout for mainboard
    [MainBoard.kicad_pcb, MainBoard.kicad_sch]
2026-03-16 Started 2 layer mainboard, switching to 4 layer
    [MainBoard.kicad_pcb, MainBoard.kicad_sch]
2026-03-16 Completed the 4 layer main board version, ready to review
    [MainBoard4Layer.kicad_pcb, MainBoard4Layer.kicad_sch]
2026-04-06 Added action cycle to cycle modes which fixed bug preventing program mode from exiting smoothly
    [events.cpp]
2026-04-06 Fixd bug in program mode that allowed multiple digits to blink after setting the selected interval
    [events.cpp]
2026-04-23 Created a version 2 for the bps board to incorporate the improvements, added the symobls and footprint
    [MainBoard4Layer-5VPWR.gbr, MainBoard4Layer-B_Cu.gbr, MainBoard4Layer-B_Mask.gbr, MainBoard4Layer-B_Paste.gbr, MainBoard4Layer-B_Silkscreen.gbr, MainBoard4Layer-Edge_Cuts.gbr, MainBoard4Layer-F_Cu.gbr, MainBoard4Layer-F_Mask.gbr]
2026-04-30 Routing bps_board_v2
    [bps_board_v2.kicad_pcb, bps_board_v2.kicad_sch]
2026-05-01 Completed bps_v2
    [bps_board_v2-B_Cu.gbr, bps_board_v2-B_Mask.gbr, bps_board_v2-B_Paste.gbr, bps_board_v2-B_Silkscreen.gbr, bps_board_v2-Edge_Cuts.gbr, bps_board_v2-F_Cu.gbr, bps_board_v2-F_Mask.gbr, bps_board_v2-F_Paste.gbr]
2026-05-04 Working on esp buttons
2026-05-05 Fixed CMake issue, contined writing the buttons.c file
    [button_poll.c, sd_card.h]
2026-05-06 continued working on buttons.c. Added events folder
2026-05-07 Finshed buttons, working through errors, set up test in main
    [button_poll.cpp, main.cpp]
2026-05-08 Tested on ESP, troubleshooting reset
    [button_poll.cpp, button_poll.h, events.h, main.cpp]
2026-05-11 troubleshooting buttons
2026-05-15 Troubleshooting buttons, found issue with the edge_detect
    [button_poll.cpp, main.cpp]
2026-05-16 Buttons work
2026-05-19 Added sd items to test via fixed array
    [sd_card.cpp, sd_card.h]
2026-05-27 pg mode functional, fixed issues with display and state machine
    [display.cpp, display.h, events.cpp, events.h]
2026-05-28 fixed sd errors, made c file
    [sd_card.c, sd_card.h]
2026-06-01 added sd items to events, troubleshooting issue
    [events.cpp, events.h, main.cpp, sd_card.c]
2026-06-30 Fixed SD card, changed to not use test array
    [events.cpp, sd_card.c]
